abodenha/c64_keyboard/(commit log)

2023-06-19 Got keys mapping correctly on windows
    [code.py]
2023-07-09 Added PCB files
    [copper_bottom.gbr, copper_top.gbr, drill_1_16.xln, gerber_job.gbrjob, profile.gbr, silkscreen_bottom.gbr, silkscreen_top.gbr, soldermask_bottom.gbr]
2023-07-15 Added links to places to get the PCBs and polished text.
2024-09-22 Create c64_keyboard.ino
    Start work on porting to arduino
2024-10-05 Fix typo in key handling and add keys to map
    [c64_keyboard.ino]
